efabless/strive/doc/striVe.png

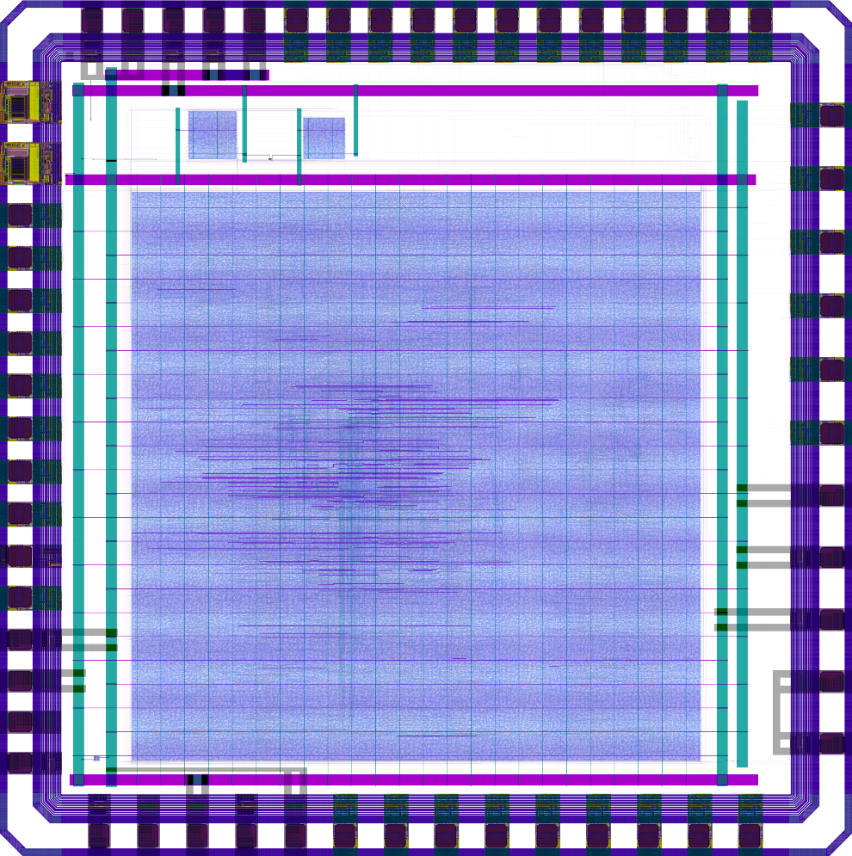
doc/striVe.png
