efabless/strive/README.md

# striVe SoC Development Board Design & Documentation

------>>>> WORK IN PROGRESS <<<<-------
