efabless/strive/doc/striVe_block_diagram.pdf

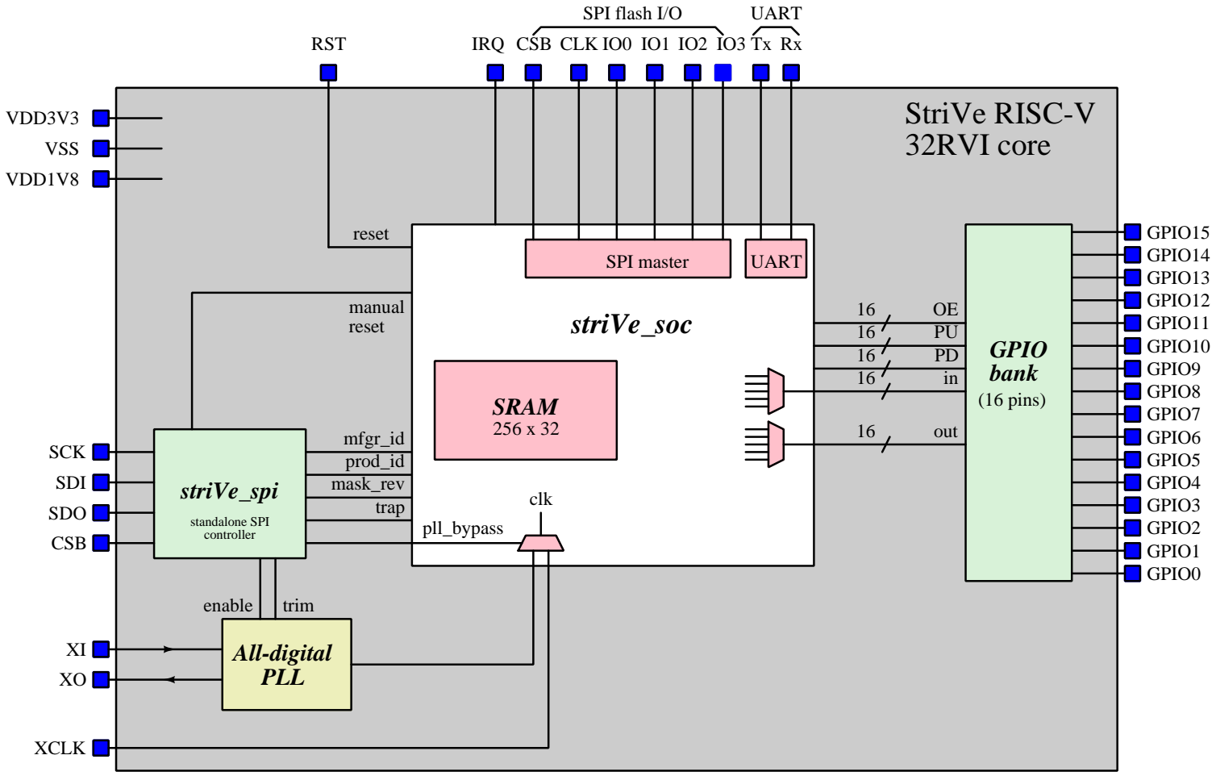
[picture p2: figure]
striVe_soc; GPIO bank; out; (16 pins); striVe_spi; SCK SDI SDO CSB; VDD3V3; VDD1V8; VSS; All-digital PLL; XCLK; pll_bypass; clk; enable; trim; mfgr_id prod_id mask_rev; reset; manual reset; IRQ; trap; SRAM; SPI flash I/O; UART; standalone SPI controller; CSB CLK IO0 IO1 IO2 IO3; SPI master; GPIO0; GPIO1; GPIO2; GPIO3; GPIO4; GPIO5; GPIO6; GPIO7; GPIO8; GPIO9; GPIO10; GPIO11; GPIO12; GPIO13; GPIO14; GPIO15; RST; StriVe RISC-V 32RVI core
