efabless/strive/pcb/assy/strive_back.png

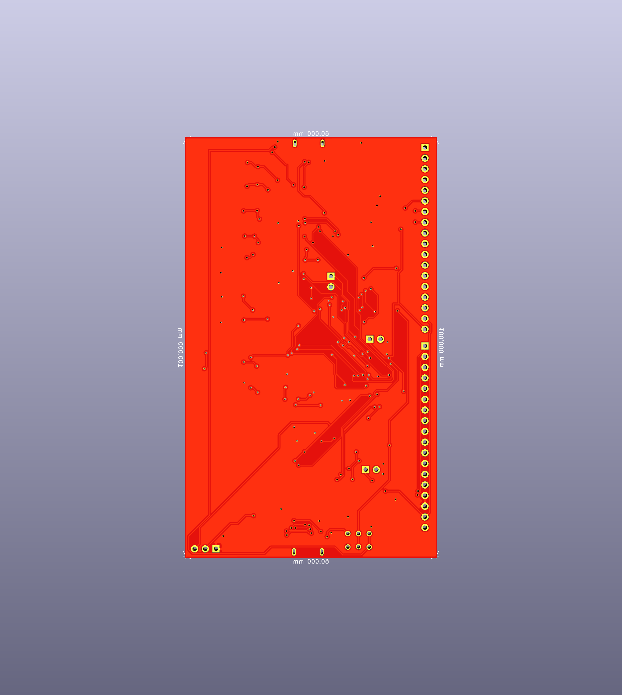
pcb/assy/strive_back.png
