efabless/strive/pcb/assy/strive_front.png

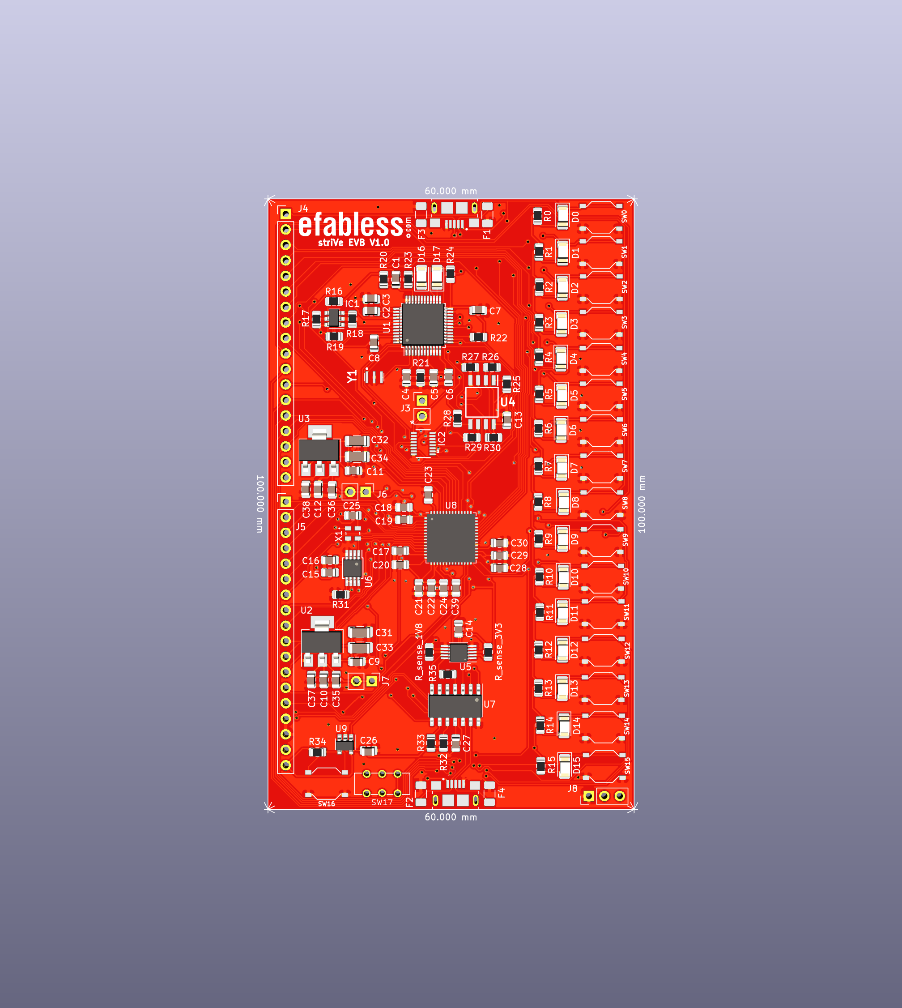
pcb/assy/strive_front.png
