efabless/strive/pcb/BOM.xlsx

MPN | count | description | seller
CC0805KKX5R8BB106 | 4 | 10 uf 0805 capacitor | Seeed OPL
CC0805KRX7R9BB104 | 24 | 0.1uf 0805 capacitor | Seeed OPL
GRM31CR60J107ME39L | 4 | 100uf 1206 capacitor | Seeed OPL
CC0805MKX5R5BB226 | 2 | 22uf 0805 capacitor | Seeed OPL
CC0805JRX7R9BB103 | 2 | 0.01uf 0805 capacitor | Seeed OPL
SKQGADE010 | 17 | SMD Button;260gf | Seeed OPL
17-215SURC/S530-A2/TR8 | 18 | SMD 08085 LED Clear-Red | Seeed OPL
10118193-0001LF | 2 | USB-B micro connector | Seeed OPL
KT8-1000SMD1206 | 4 | SMD PPTC 1A-15V 1206 Fuse | Seeed OPL
MS-22D18 G2 ROHS | 1 | DIP Switch;SPDT;200gf | Seeed OPL
RC0805FR-0710KL | 15 | 0805 RES 10K-1%-1/8W | Seeed OPL
0805W8F1202T5E | 1 | 0805 12KΩ ±1% 1/8W | ShenZhen OPL
0805W8F820JT5E | 16 | 0805 82Ω ±1% 1/8W | ShenZhen OPL
0805W8J0151T5E | 2 | 0805 150Ω ±5% 1/8W | ShenZhen OPL
0805W8F300LT5F | 2 | 0805 0.3Ω ±1% 1/8W | ShenZhen OPL
CR0805J80202G | 1 | 0805 2KΩ ±5% 1/8W | ShenZhen OPL
MCP1826ST-3302E/DB | 1 | IC REG LDO 3.3V 1A SOT223-3 | ShenZhen OPL
AZ1117CH-1.8TRG1 | 1 | IC REG LDO 1.8V 0.8A SOT223 | ShenZhen OPL
FT232HL-REEL (https://www.digikey.com/en/products/detail/ftdi-future-technology-devices-international-ltd/FT232HL-REEL/2614627) | 1 | FTDI | digikey
W25Q32FVSS | 1 | QSPI | digikey
TMUX1574DYYR | 1 | Multiplexer | digikey
DSC6001JE1A-010.0000 | 1 | 10MHz oscillator | digikey
DS1086LU+T | 1 | configurable oscillator | digikey
MCP2221A | 1 | IC USB TO I2C BRIDGE DEVICE 14SO | digikey
INA2181A1IDGSR | 1 | current sense amplifier | digikey
MCP1319T-29LE/OT | 1 | IC SUPERVISOR 1 CHANNEL SOT23-5 | digikey
CSTNE12M0GH5L000R0 | 1 | Crystal oscillator for FTDI | digikey
striVe | 1 | SoC
