efabless/strive/pcb/Updated_BOM_revised.xlsx

Designator | MPN | Quantity | Linl
C9,C11,C36,C35 | CC0805KKX5R8BB106 | 4
C16,C25,C17,C20,C28,C29,C30,C24,C27,C22,C21,C18,C23,C14,C26,C2,C3,C8,C7,C6,C5,C4,C13,C19,C39 | CC0805KRX7R9BB104 | 25
C31,C32,C33,C34 | GRM31CR60J107ME39L | 4
C10,C12 | CC0805MKX5R5BB226 | 2
C1,C15 | CC0805JRX7R9BB103 | 2
C37,C38 | CC0805KKX7R8BB105 | 2
SW0,SW1,SW2,SW3,SW4,SW5,SW6,SW7,SW8,SW9,SW10,SW11,SW12,SW13,SW14,SW15,SW16 | SKQGADE010 | 17
D0,D1,D2,D3,D4,D5,D6,D7,D8,D9,D10,D11,D12,D13,D14,D15,D16,D17 | 17-215SURC/S530-A2/TR8 | 18
J1,J2 | 10118193-0001LF | 2
F1,F2,F3,F4 | KT8-1000SMD1206 | 4
SW17 | MS-22D18 G2 ROHS | 1
R33,R32,R16,R17,R19,R20,R30,R29,R28,R27,R26,R25,R34,R31,R22 | RC0805FR-0710KL | 15
R35 | RC0805JR-071KL | 1
R21 | 0805W8F1202T5E | 1
R1,R0,R3,R2,R5,R4,R7,R6,R9,R8,R11,R10,R13,R12,R15,R14 | 0805W8F820JT5E | 16
R23,R24 | 0805W8J0151T5E | 2
R_sense_3V3, R_sense_1V8 | 0805W8F300LT5F | 2
R18 | CR0805J80202G | 1
U3 | MCP1826ST-3302E/DB | 1
U2 | AZ1117CH-1.8TRG1 | 1
U1 | FT232HL-REEL (https://www.digikey.com/en/products/detail/ftdi-future-technology-devices-international-ltd/FT232HL-REEL/2614627) | 1
U4 | W25Q32JVSSIQ | 1 | https://www.digikey.cn/en/products/detail/winbond-electronics/W25Q32JVSSIQ/5803981
IC2 | TMUX1574DYYR | 1
X1 | DSC6001JE1A-010.0000 | 1 | https://www.digikey.cn/en/products/detail/microchip-technology/DSC6001JE1A-010-0000/7732720
U6 | DS1086LU+T | 1
U7 | MCP2221A | 1 | https://www.mouser.cn/ProductDetail/Microchip-Technology/MCP2221A-I-SL/
U5 | INA2181A1IDGSR | 1 | https://www.digikey.cn/en/products/detail/texas-instruments/INA2181A1IDGSR/8038166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
U9 | MCP1319T-29LE/OT | 1
Y1 | CSTNE12M0GH5L000R0 | 1
U8 | striVe 'SV1' | 1 | customer provided
U8 | striVe 'SV2' | 1 | customer provided
