efabless/strive/pkg/striVe_bond.pdf

## striVe wirebond in 56-pin QFN

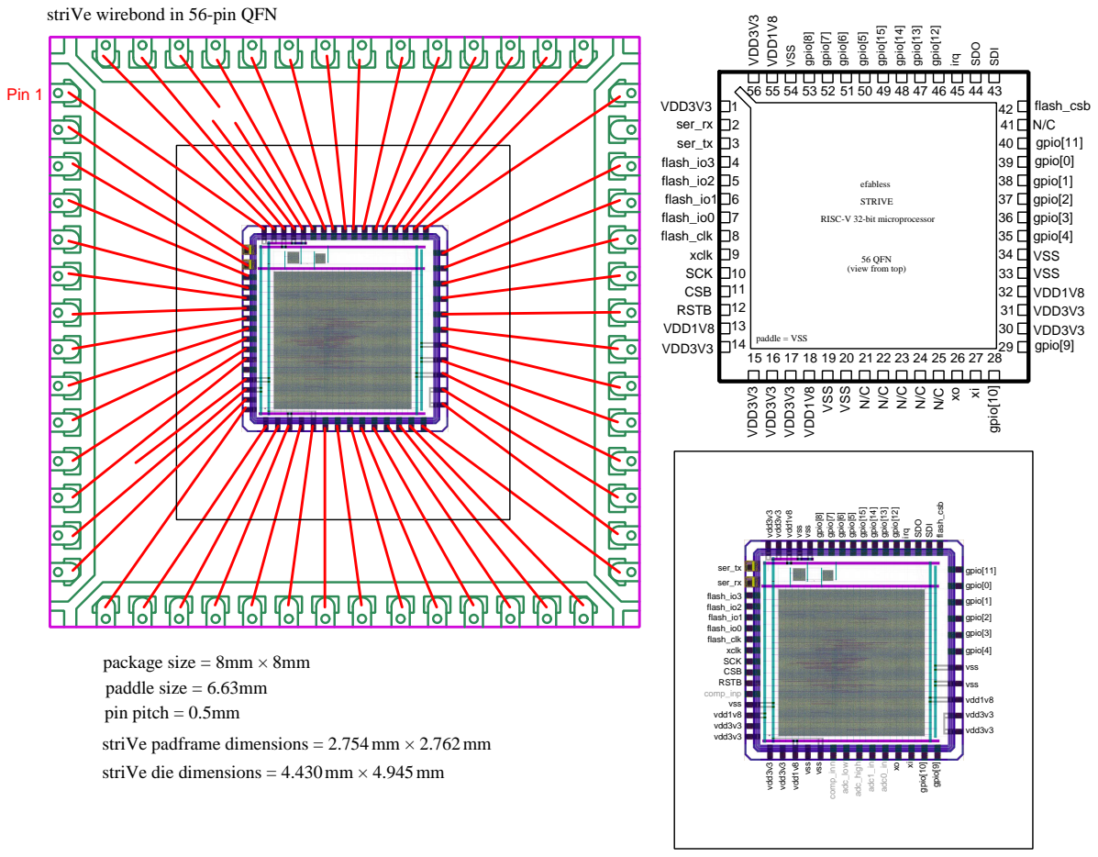
[picture p5: page 1]
STRIVE; paddle = VSS 14; efabless; VSS; gpio[8]; gpio[7]; gpio[6]; gpio[5]; gpio[15]; gpio[14]; gpio[13]; gpio[12]; irq; SDO; SDI; flash_csb; gpio[11] gpio[0] gpio[1] gpio[2] gpio[3] gpio[4] VSS VSS VDD1V8 VDD3V3 VDD3V3; gpio[10]; VDD3V3; VDD1V8; RSTB; CSB; SCK; xclk; flash_clk; flash_io0; flash_io1; flash_io2; flash_io3; ser_tx; ser_rx; gpio[9]; Pin 1; vdd3v3; vdd1v8; vss; comp_inp; gpio[11]; gpio[0]; gpio[1]; gpio[2]; gpio[4]; gpio[3]; adc1_in; adc0_in; adc_high; adc_low; comp_inn

RISC-V 32-bit microprocessor

56 QFN
(view from top)

package size = 8mm × 8mm
paddle size = 6.63mm
pin pitch = 0.5mm
striVe padframe dimensions = 2.754 mm × 2.762mm

vdd1v8 striVe die dimensions = 4.430mm × 4.945 mm
