efabless/strive/pkg/strive_bond_orig.pdf

## striVe wirebond in 48-pin QFN

### Pin 1

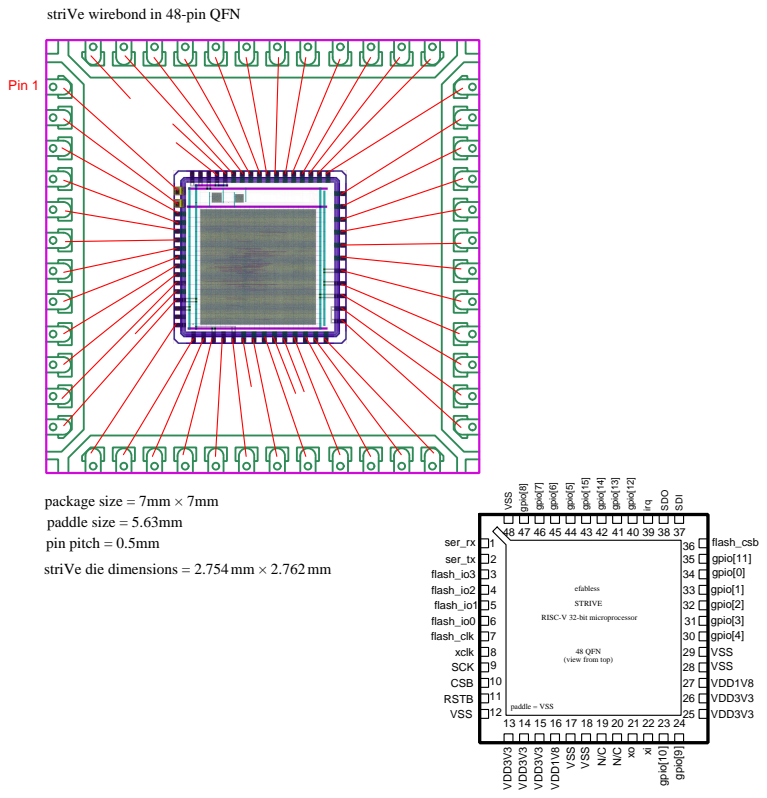
[picture p6: page 1]
STRIVE; paddle = VSS 12; efabless; VSS; gpio[8]; gpio[7]; gpio[6]; gpio[5]; gpio[15]; gpio[14]; gpio[13]; gpio[12]; irq; SDO; SDI; flash_csb gpio[11] gpio[0] gpio[1] gpio[2] gpio[3] gpio[4] VSS VSS VDD1V8 VDD3V3 VDD3V3; gpio[9]; gpio[10]; VDD3V3; VDD1V8; RSTB; CSB; SCK; xclk; flash_clk; flash_io0; flash_io1; flash_io2; flash_io3; ser_tx; ser_rx

package size = 7mm × 7mm
paddle size = 5.63mm
pin pitch = 0.5mm
striVe die dimensions = 2.754 mm × 2.762mm

RISC-V 32-bit microprocessor

48 QFN
(view from top)
